Kevin-Woodman/ME_405_Romi/docs/RomiRender_AssemblywServo.jpg

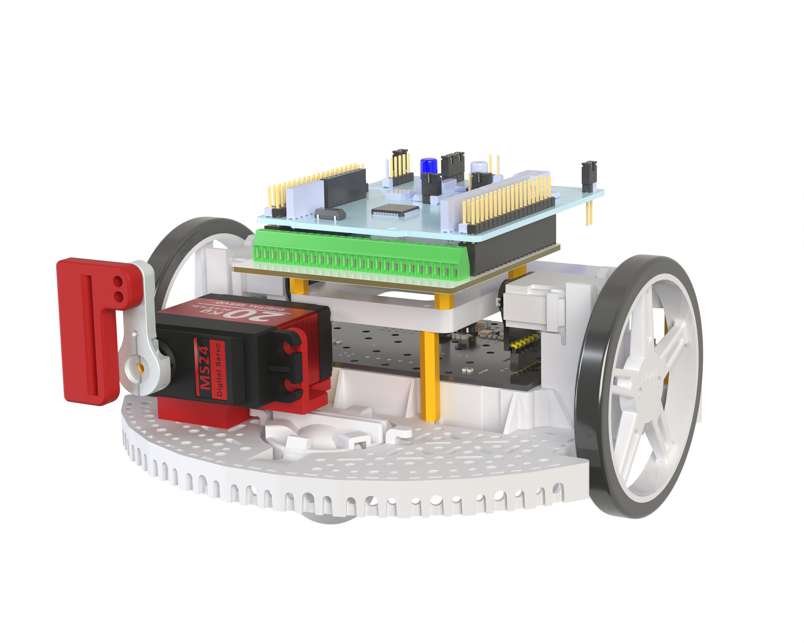
docs/RomiRender_AssemblywServo.jpg
