Kevin-Woodman/ME_405_Romi/docs/RomiRender_Assembly.jpg

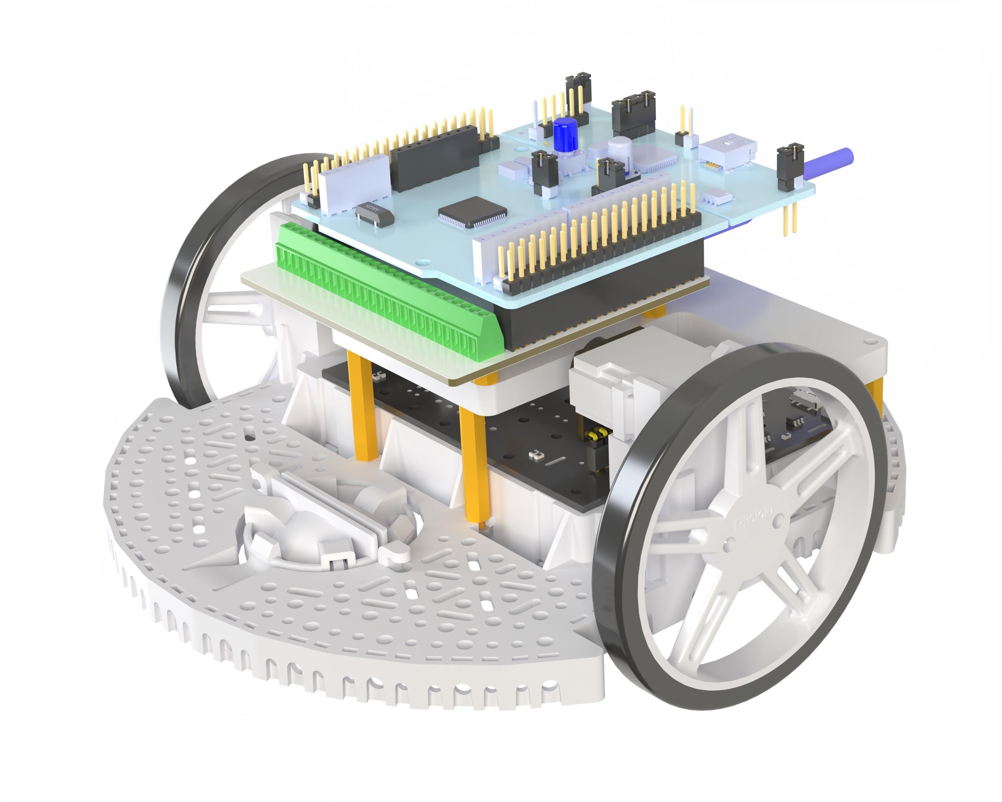
docs/RomiRender_Assembly.jpg
