Kevin-Woodman/ME_405_Romi/docs/BlankGameTrack.jpg

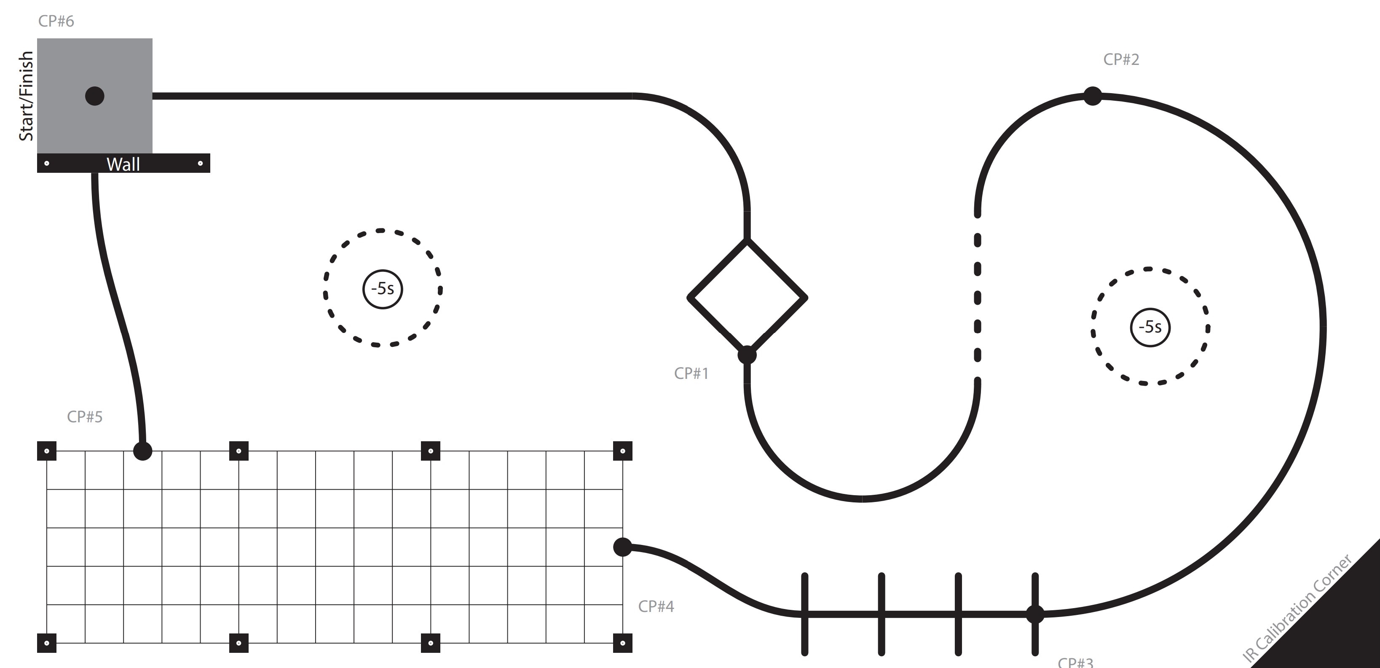
docs/BlankGameTrack.jpg
