Kevin-Woodman/ME_405_Romi/docs/BlockDiagram.png

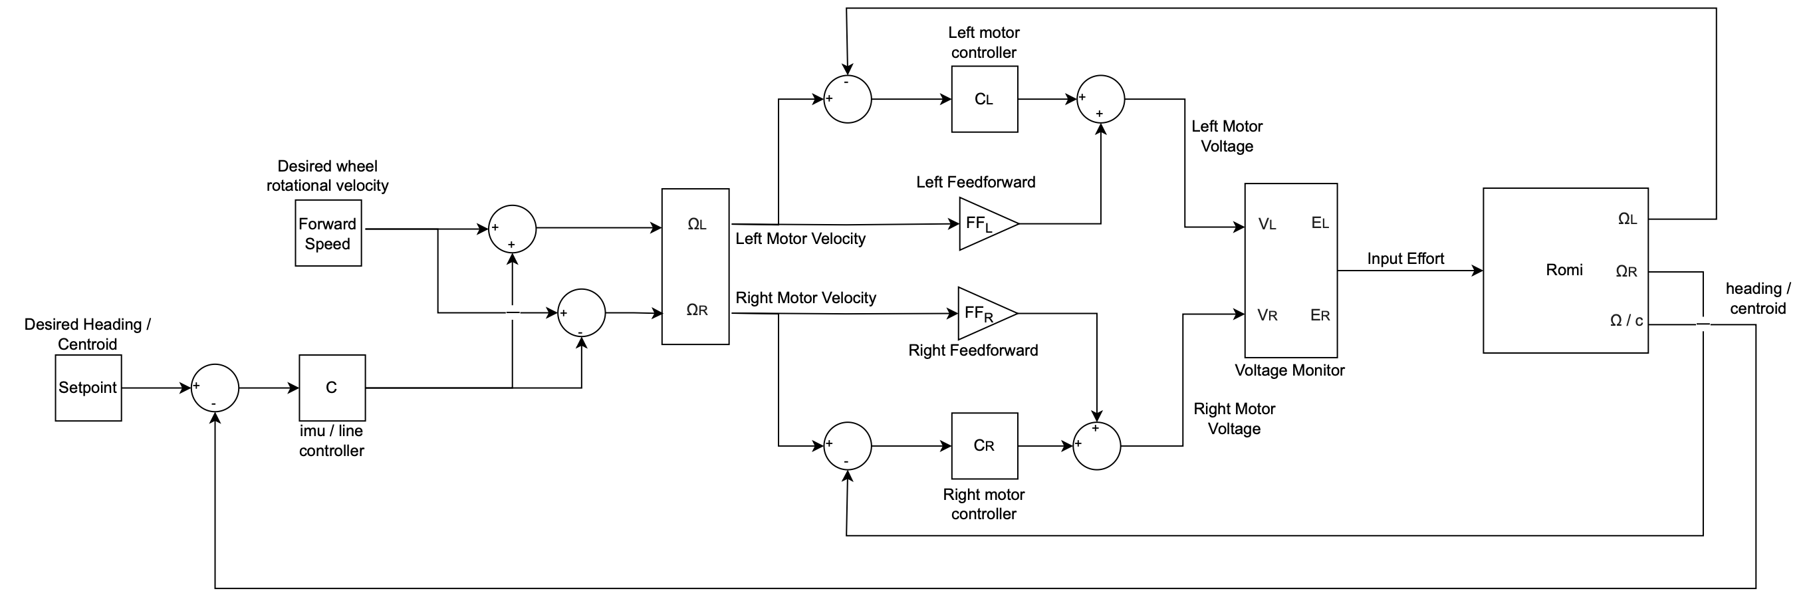
docs/BlockDiagram.png
