Kevin-Woodman/ME_405_Romi/docs/centroid.png

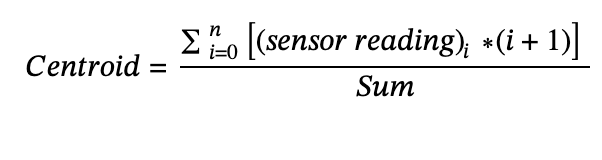
docs/centroid.png
