Kevin-Woodman/ME_405_Romi/docs/FinalTaskDiagram.jpg

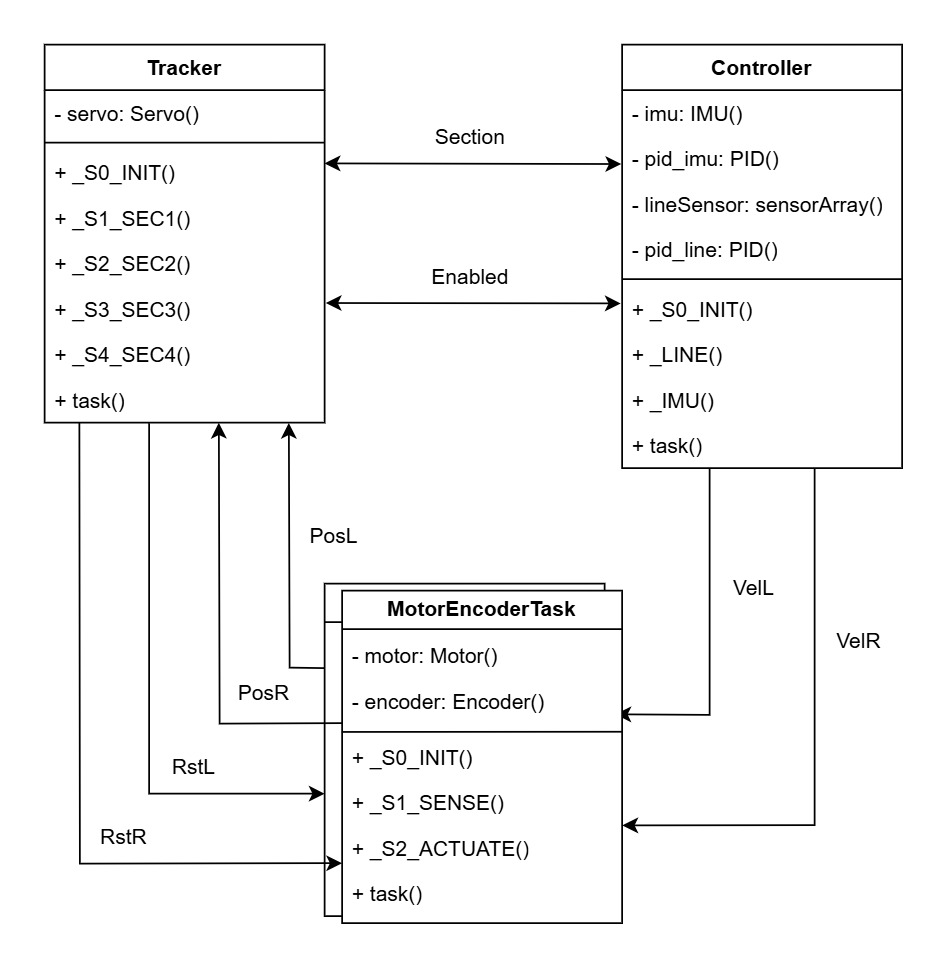
docs/FinalTaskDiagram.jpg
