Kevin-Woodman/ME_405_Romi/docs/GainGraph.png

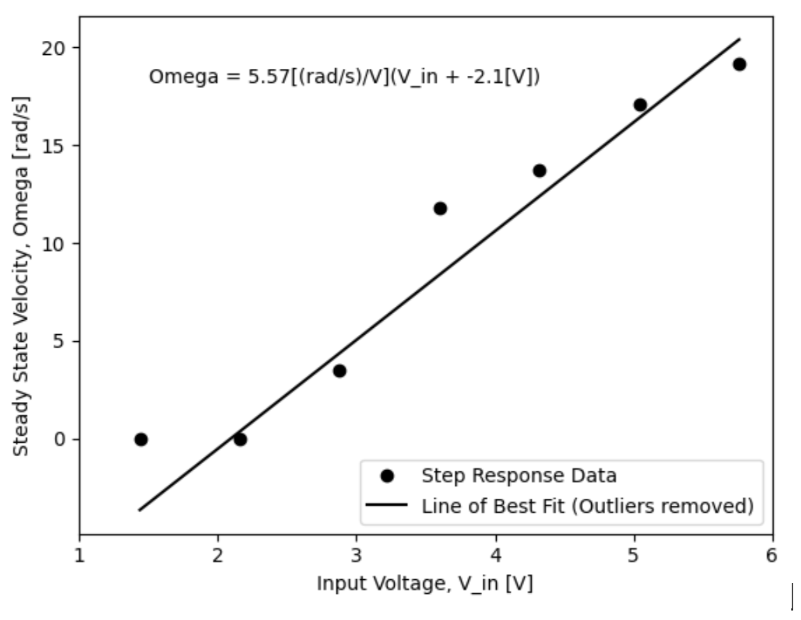
docs/GainGraph.png
