Kevin-Woodman/ME_405_Romi/docs/Gametrack Diagram.jpg

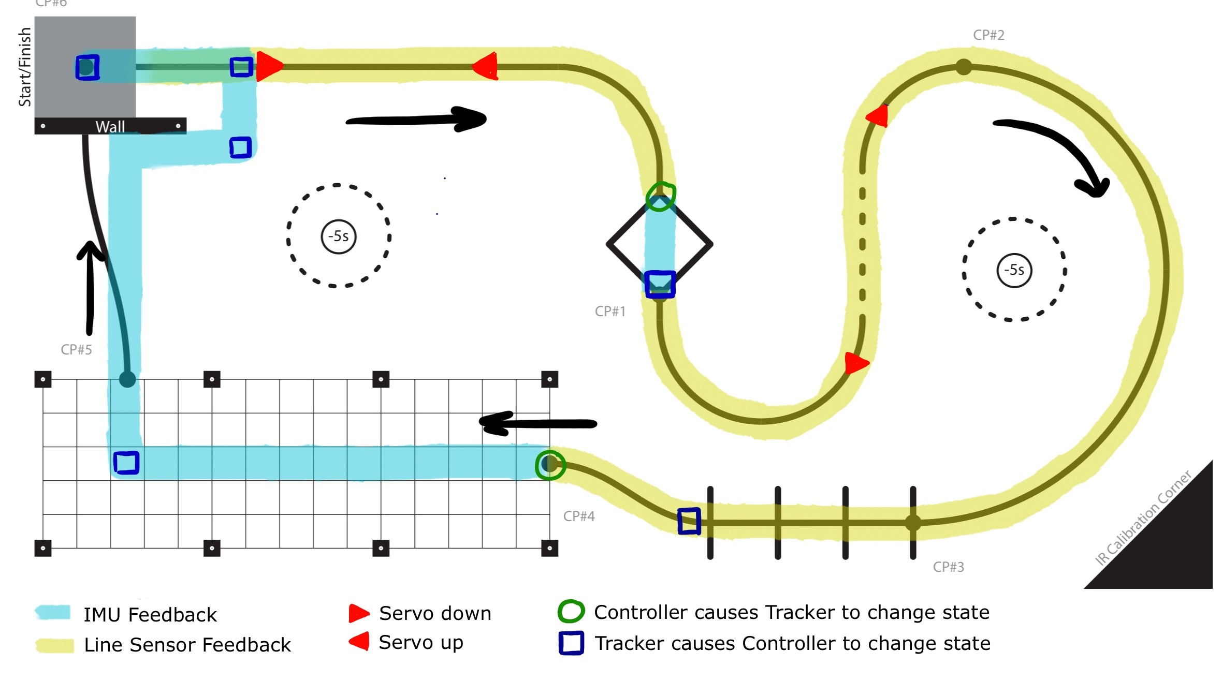
docs/Gametrack Diagram.jpg
