Kevin-Woodman/ME_405_Romi/docs/Romi.png

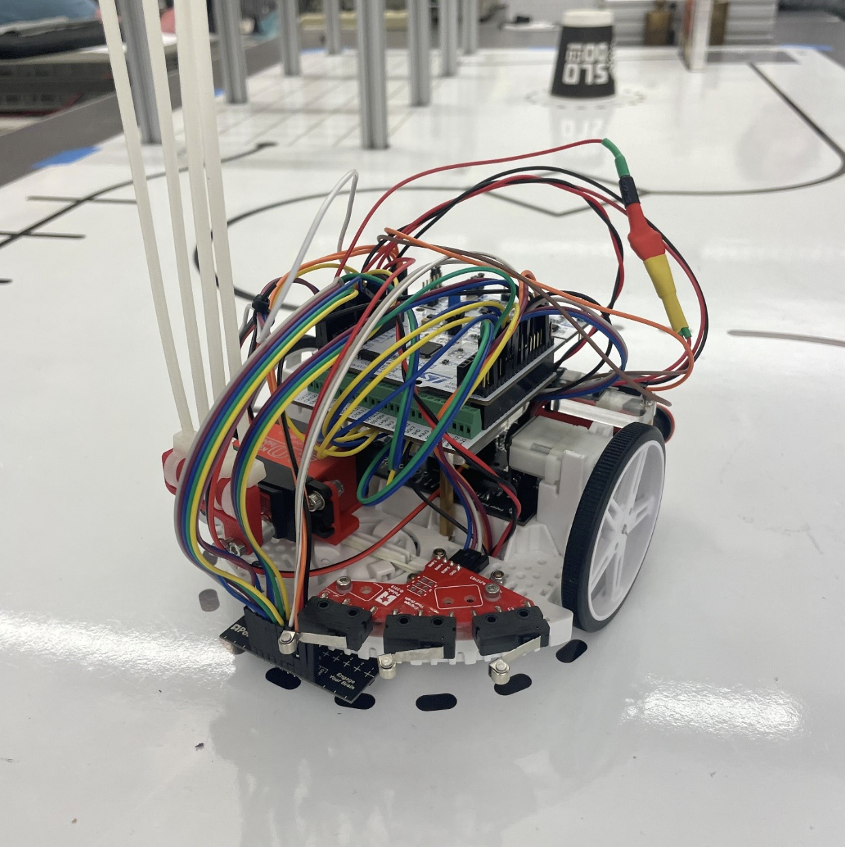
docs/Romi.png
