Kevin-Woodman/ME_405_Romi/docs/RomiRender_Adapter.jpg

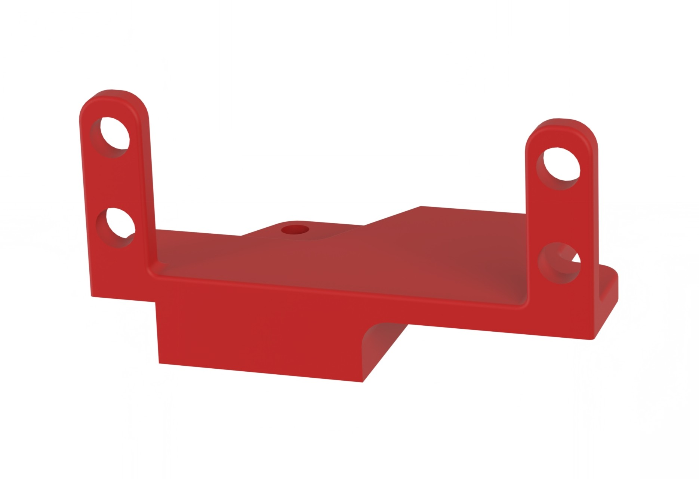
docs/RomiRender_Adapter.jpg
