Kevin-Woodman/ME_405_Romi/docs/RomiRender_Bracket.jpg

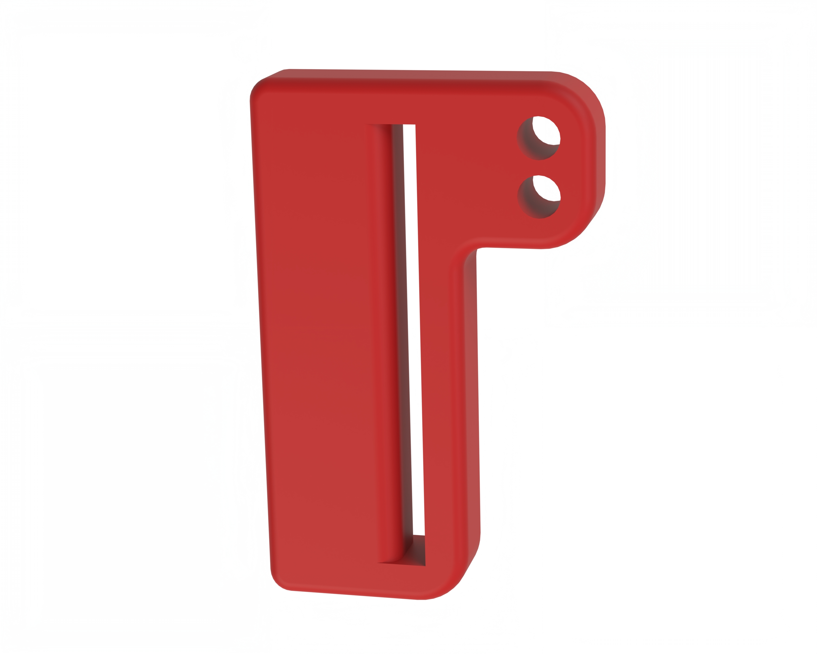
docs/RomiRender_Bracket.jpg
