Kevin-Woodman/ME_405_Romi/docs/Sumval.png

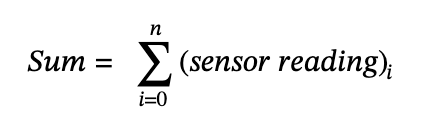
docs/Sumval.png
