Kevin-Woodman/ME_405_Romi/docs/Voltage Divider.png

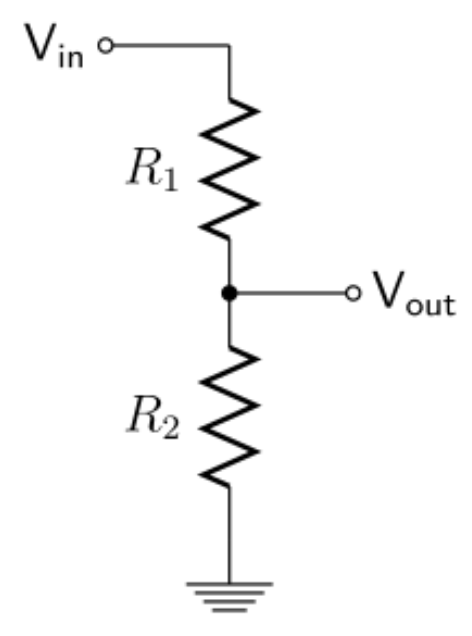
docs/Voltage Divider.png
