Kevin-Woodman/ME_405_Romi/CAD/STEP214 Servo Arm for DS3218MG.STEP

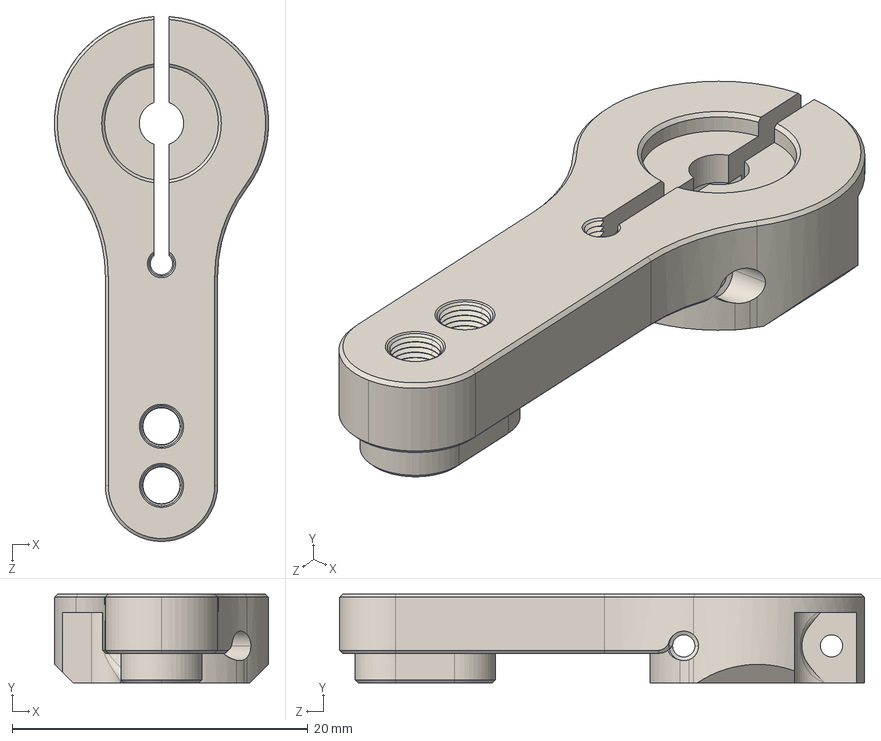
[picture p14: CAD file, 2025-03-17]
CAD/STEP214 Servo Arm for DS3218MG.STEP
14.5 x 6.00 x 35.5 mm
