Kevin-Woodman/ME_405_Romi/CAD/Romi_ServoBracket_STEP.STEP

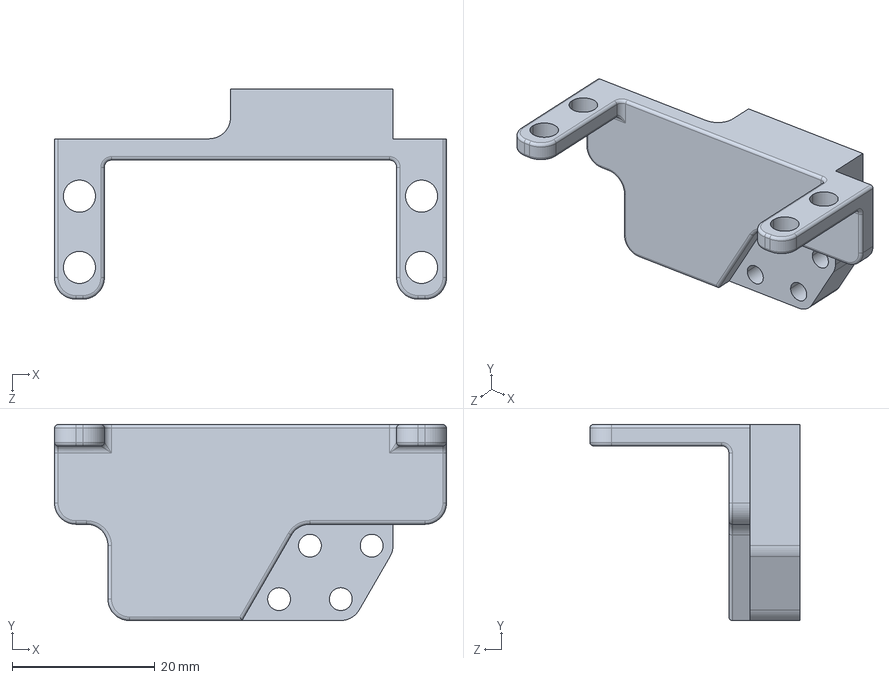
[picture p15: CAD file, 2025-03-17]
CAD/Romi_ServoBracket_STEP.STEP
55.0 x 27.5 x 29.5 mm
