Kevin-Woodman/ME_405_Romi/CAD/Romi_ServoBracket.SLDPRT

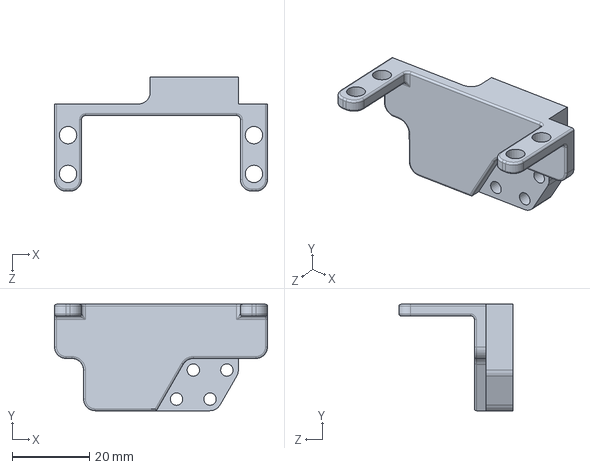
[picture p16: CAD file, 2025-03-17]
CAD/Romi_ServoBracket.SLDPRT
55.0 x 27.5 x 29.5 mm
