Kevin-Woodman/ME_405_Romi/CAD/Romi_ServoHornZipTieAdapter.SLDPRT

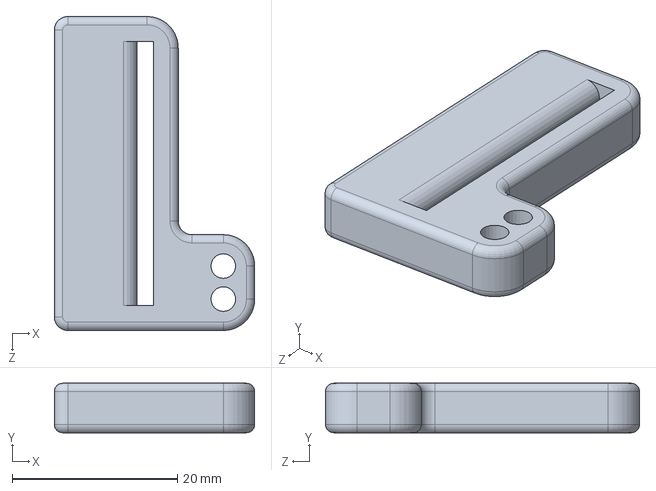
[picture p17: CAD file, 2025-03-17]
CAD/Romi_ServoHornZipTieAdapter.SLDPRT
24.2 x 6.00 x 38.0 mm
