Kevin-Woodman/ME_405_Romi/(list of files, cad)

Other CAD files:
CAD/Romi_ServoHornZipTieAdapter_STEP.STEP
