Kevin-Woodman/ME_405_Romi/docs/Final Wiring Diagram.jpg

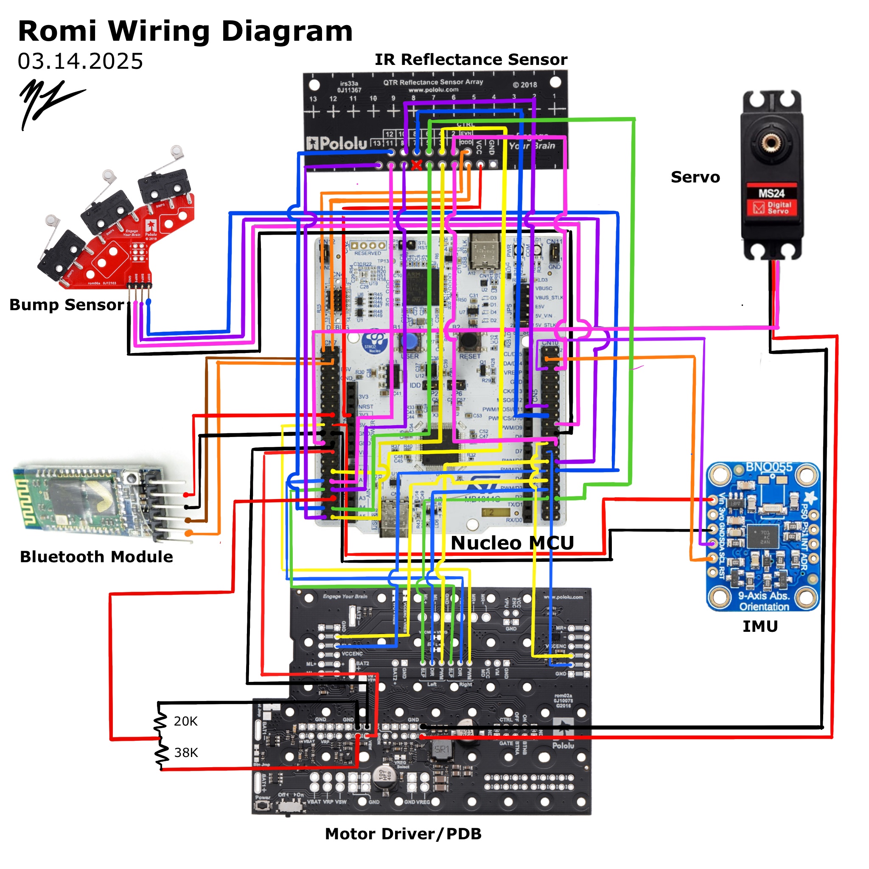
docs/Final Wiring Diagram.jpg
