Kevin-Woodman/ME_405_Romi/(commit log)

2025-03-14 Documentation for Motor.py
2025-03-16 Added white bg to Voltage Divider
2025-03-17 Created CAD Folder
2025-03-17 Added CAD files
    [Romi_ServoBracket.SLDPRT, Romi_ServoBracket_STEP.STEP, Romi_ServoHornZipTieAdapter.SLDPRT, Romi_ServoHornZipTieAdapter_STEP.STEP, STEP214 Servo Arm for DS3218MG.STEP]
